winneymj/epoch_coincell_4layer/epoch.kicad_pcb

## KiCad design epoch.kicad_pcb (2018-03-05)

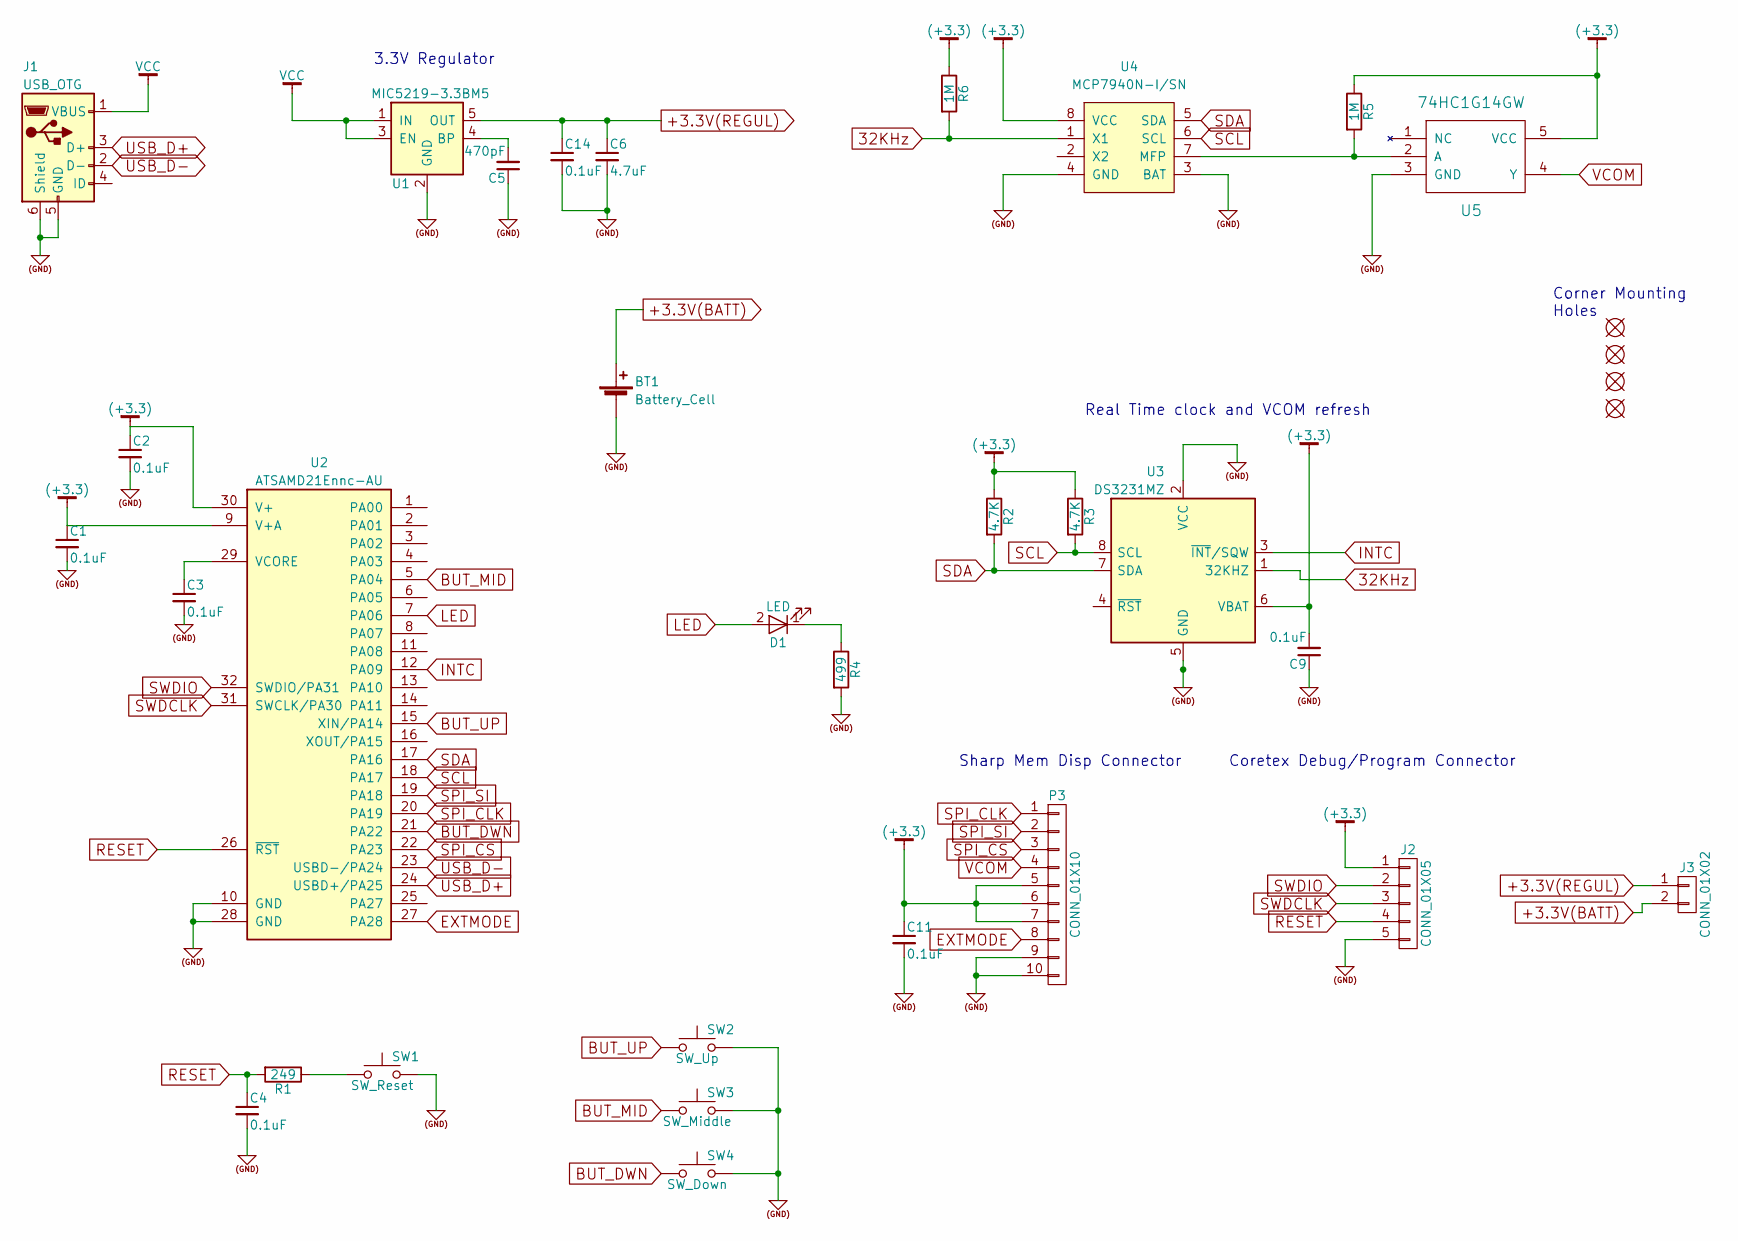
[picture p1: schematic epoch.sch]

Parts:
BT1: Battery_Cell; CR2032-001
C1, C2, C3, C4, C9, C11, C14: 0.1uF; C_0805_HandSoldering
C5: 470pF; C_0805_HandSoldering
C6: 4.7uF; C_0805_HandSoldering
D1: LED; LED_0805
J1: USB_OTG; USB-MICROB_LARGEPAD
J2: CONN_01X05; Pin_Header_Straight_1x05_Pitch1.27mm
J3: CONN_01X02; Pin_Header_Straight_1x02_Pitch1.27mm
P3: CONN_01X10; MOLEX_0.5MM_505278
R1: 249; R_0805_HandSoldering
R2, R3: 4.7K; R_0805_HandSoldering
R4: 499; R_0805_HandSoldering
R5, R6: 1M; R_0805_HandSoldering
SW1: SW_Reset; SW_SPST_B3U-3000P
SW2: SW_Up; SW_SPDT_EBAY_3PIN_VERT
SW3: SW_Middle; SW_SPDT_EBAY_3PIN_VERT
SW4: SW_Down; SW_SPDT_EBAY_3PIN_VERT
U1: MIC5219-3.3BM5; SOT-23-5
U2: ATSAMD21Ennc-AU; TQFP-32_7x7mm_Pitch0.8mm; MPN ATSAMD21Ennc-AU
U3: DS3231MZ; SOIC-8_3.9x4.9mm_Pitch1.27mm
U4: MCP7940N-I/SN; SOIC-8_3.9x4.9mm_Pitch1.27mm; MPN MCP7940N-I/SN
U5: 74HC1G14GW; SOT-353_SC-70-5_Handsoldering
U6, U7, U8, U9: MH2mm; MH2.1mm

Connections:
32KHz: R6.2, U3.1 (32KHZ), U4.1 (X1)
(+3.3): C1.1, C2.1, C9.2, C11.1, J2.1, P3.5, P3.6, P3.7, R2.1, R3.1, R5.1, R6.1, U2.9 (V+A), U2.30 (V+), U3.6 (VBAT), U4.8 (VCC), U5.5 (VCC)
(GND): BT1.2 (-), C1.2, C2.2, C3.2, C4.2, C5.1, C6.2, C9.1, C11.2, C14.2, J1.5 (GND), J1.6 (Shield), J2.5, P3.9, P3.10, R4.2, SW1.2, SW2.2, SW3.2, SW4.2, U1.2 (GND), U2.10 (GND), U2.28 (GND), U3.2 (VCC), U3.5 (GND), U4.3 (BAT), U4.4 (GND), U5.3 (GND)
+3.3V(BATT): BT1.1 (+), J3.2
+3.3V(REGUL): C6.1, C14.1, J3.1, U1.5 (OUT)
BUT_DWN: SW4.1, U2.21 (PA22)
BUT_MID: SW3.1, U2.5 (PA04)
BUT_UP: SW2.1, U2.15 (XIN/PA14)
EXTMODE: P3.8, U2.27 (PA28)
INTC: U2.12 (PA09), U3.3 (~INT~/SQW)
LED: D1.2 (A), U2.7 (PA06)
unnamed: C3.1, U2.29 (VCORE)
unnamed: C5.2, U1.4 (BP)
unnamed: D1.1 (K), R4.1
unnamed: R1.1, SW1.1
unnamed: R5.2, U4.7 (MFP), U5.2 (A)
RESET: C4.1, J2.4, R1.2, U2.26 (~RST)
SCL: R3.2, U2.18 (PA17), U3.8 (SCL), U4.6 (SCL)
SDA: R2.2, U2.17 (PA16), U3.7 (SDA), U4.5 (SDA)
SPI_CLK: P3.1, U2.20 (PA19)
SPI_CS: P3.3, U2.22 (PA23)
SPI_SI: P3.2, U2.19 (PA18)
SWDCLK: J2.3, U2.31 (SWCLK/PA30)
SWDIO: J2.2, U2.32 (SWDIO/PA31)
USB_D+: J1.3 (D+), U2.24 (USBD+/PA25)
USB_D-: J1.2 (D-), U2.23 (USBD-/PA24)
VCC: J1.1 (VBUS), U1.1 (IN), U1.3 (EN)
VCOM: P3.4, U5.4 (Y)

Notes on the sheet:
Coretex Debug/Program Connector
3.3V Regulator
Sharp Mem Disp Connector
Real Time clock and VCOM refresh
Corner Mounting Holes

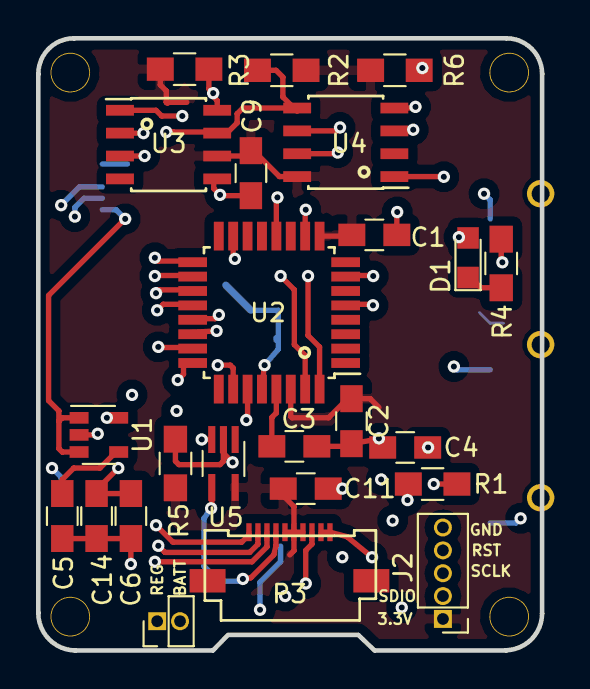
[picture p2: board epoch.kicad_pcb from above]

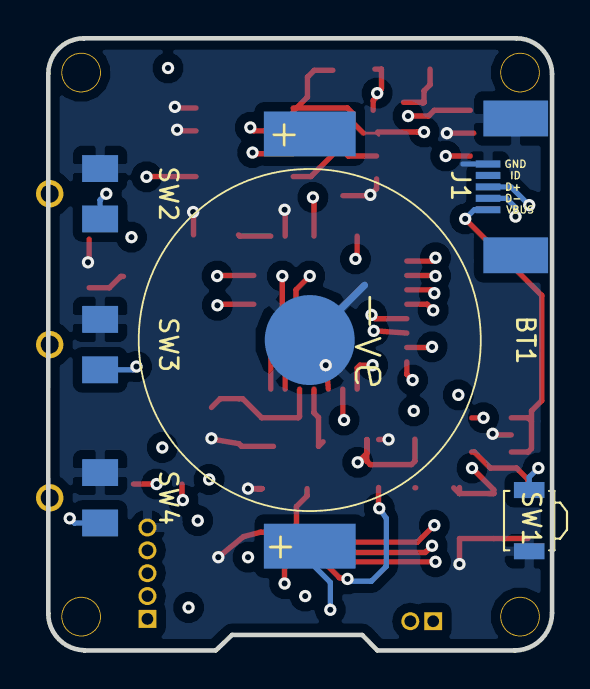
[picture p3: board epoch.kicad_pcb from below]

Board: 4 copper layers, 28.0 x 34.0 mm, 34 parts (6 on the bottom side), 28 nets.
