winneymj/epoch_coincell_4layer/epoch_program_adapter.kicad_pcb

## KiCad design epoch_program_adapter.kicad_pcb (2018-02-15)

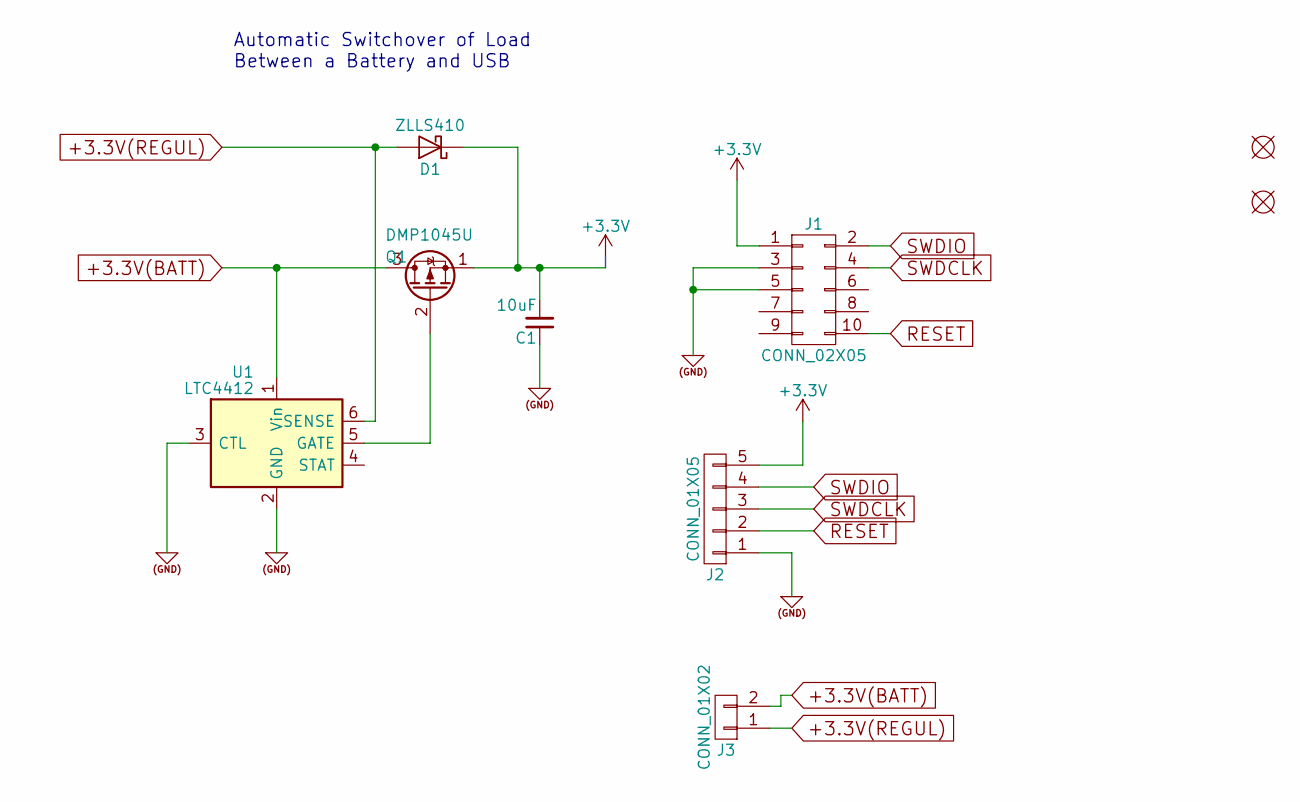
[picture p4: schematic epoch_program_adapter.sch]

Parts:
C1: 10uF; C_0805_HandSoldering
D1: ZLLS410; D_SOD-323_HandSoldering
H1, H2: MH2mm; MH2.1mm
J1: CONN_02X05; Pin_Header_Straight_2x05_Pitch1.27mm
J2: CONN_01X05; Pin_Header_Straight_1x05_Pitch1.27mm
J3: CONN_01X02; Pin_Header_Straight_1x02_Pitch1.27mm
Q1: DMP1045U; TSOT-23_HandSoldering
U1: LTC4412; SOT-23-6_Handsoldering

Connections:
(GND): C1.1, J1.3, J1.5, J2.1, U1.2 (GND), U1.3 (CTL)
+3.3V(BATT): J3.2, Q1.3 (D), U1.1 (Vin)
+3.3V(REGUL): D1.2 (A), J3.1, U1.6 (SENSE)
+3V3: C1.2, D1.1 (K), J1.1, J2.5, Q1.1 (S)
unnamed: Q1.2 (G), U1.5 (GATE)
RESET: J1.10, J2.2
SWDCLK: J1.4, J2.3
SWDIO: J1.2, J2.4

Notes on the sheet:
Automatic Switchover of Load Between a Battery and USB

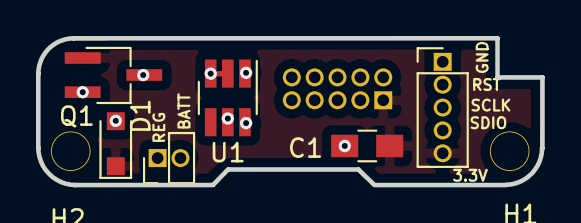
[picture p5: board epoch_program_adapter.kicad_pcb from above]

Board: 4 copper layers, 28.0 x 8.2 mm, 9 parts (1 on the bottom side), 8 nets.
