winneymj/epoch_coincell_4layer/(commit log)

2017-05-10 Final connections
    [epoch-B.Cu.gbl, epoch-B.Mask.gbs, epoch-B.SilkS.gbo, epoch-Edge.Cuts.gm1, epoch-F.Cu.gtl, epoch-F.Mask.gts, epoch-F.SilkS.gto, epoch.drl]
2017-05-12 New buttons
    [_saved_epoch.sch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]
2017-05-13 Update all buttons and re-route
    [epoch.kicad_pcb]
2017-05-13 final. Sent to manufacturer
    [epoch-B.Cu.gbl, epoch-B.Mask.gbs, epoch-B.SilkS.gbo, epoch-Edge.Cuts.gm1, epoch-F.Cu.gtl, epoch-F.Mask.gts, epoch-F.SilkS.gto, epoch.drl]
2017-08-03 Correct interrupt connections to pins that actually support interrupts
    [epoch.csv, epoch.kicad_pcb, epoch.sch]
2017-08-22 New version with crystal removed and 32Khz output into XTA of 2nd RTC
    [epoch.kicad_pcb, epoch.sch]
2017-09-10 Add Automatic Switchover of Load Between a Battery
    [epoch.sch]
2017-09-10 Add drills back to PCB...Note this PCB does not include the battery protection switch which is shown in the schematic.
    Not sure I have the PBC space to do this. Maybe do a separate board. Not sure.
    [epoch.kicad_pcb]
2017-09-10 Revert "Add drills back to PCB...Note this PCB does not include the battery protection switch which is shown in the schematic."
    This reverts commit 0a23e0f0d40f65d1b6f1174f50c74f54a2cdcd00.
    [epoch.kicad_pcb]
2017-09-10 Revert "Add Automatic Switchover of Load Between a Battery"
    This reverts commit 427980174dfe5bb42044178e8a82d6b50698685d.
    [epoch.sch]
2017-09-10 Add back corner drill holes
    [epoch.kicad_pcb]
2017-09-10 correct the routing after adding drills back
    [epoch.kicad_pcb]
2017-09-22 Update drills
    [epoch.kicad_pcb, epoch.sch]
2017-09-23 Use same connector for hotswap
    [epoch.kicad_pcb, epoch.sch]
2017-09-23 Implement new schematic for adapter board
    [epoch_program_adapter.kicad_pcb, epoch_program_adapter.sch]
2017-09-24 Increase drill size to 2.1. Rework daughter board
    [epoch.kicad_pcb, epoch.sch, epoch_program_adapter.kicad_pcb, epoch_program_adapter.sch]
2017-09-26 V2.0 - Manufactured Board and Adapter
    [epoch-B.Cu.gbl, epoch-B.Mask.gbs, epoch-B.SilkS.gbo, epoch-Edge.Cuts.gm1, epoch-F.Cu.gtl, epoch-F.Mask.gts, epoch-F.SilkS.gto, epoch.drl]
2018-02-05 update for RTC battery grounding and clock pull-up increased to 1M to reduce power consumption
    [epoch.kicad_pcb, epoch.sch]
2018-02-16 Update PCB to move battery and USB
    [epoch.kicad_pcb]
2018-03-05 Move reference text
    [epoch.kicad_pcb]
